jas21RICE/ENGI301/project_02/docs/Board_Screenshot.JPG

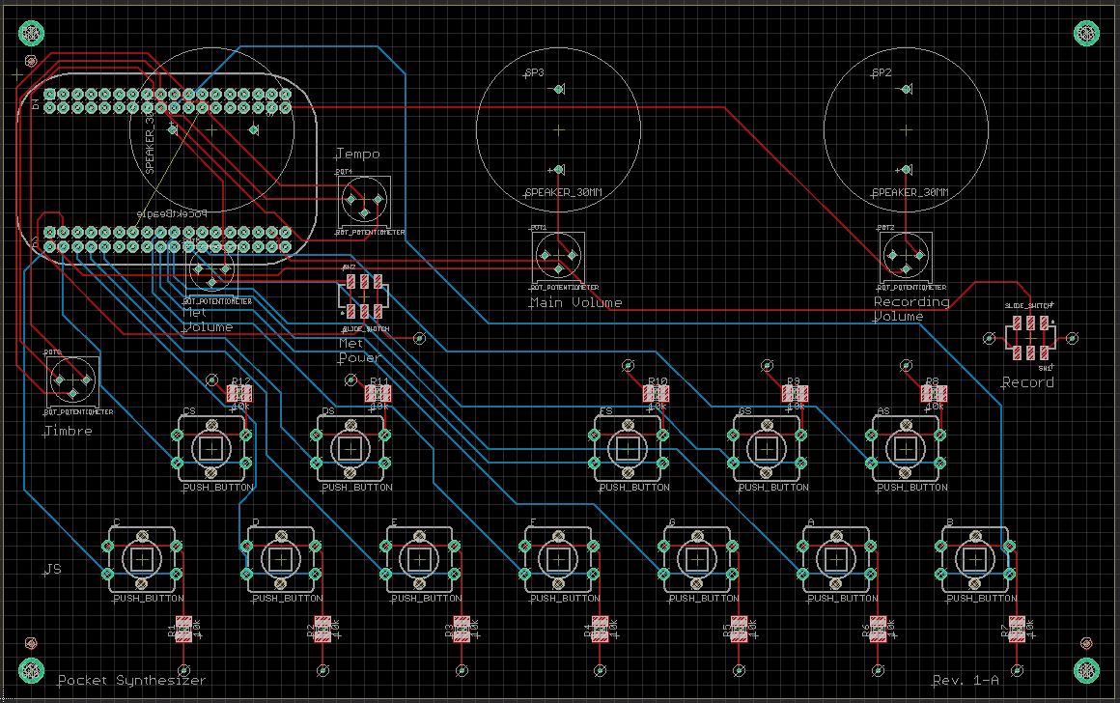
project_02/docs/Board_Screenshot.JPG
