jas21RICE/ENGI301/README.md

# ENGI301
Repository for ENGI 301 course work
