jas21RICE/ENGI301/project_02/README.md

# project_2
Repository for files regarding the Pocket Synthesizer PCB. 
These files are for manufacturing a PCB for a Pocket Synthesizer using the BeagleBoard PocketBeagle.
The project details can be found here: https://www.hackster.io/jas21/pocketbeagle-synthesizer-10f638
