jas21RICE/ENGI301/synthesizer_PCB/docs/ENGI301_project_2_proposal.pptx

## ENGI 301 Synthesizer PCB Proposal

10/20/2019
Josh Stelling

## Board Functionality

- This project will be a PCB that uses a PocketBeagle to make a miniature piano/synthesizer. The synthesizer has 12 keys, enough to cover a single octave of musical notes, and several other functions. There is a metronome that can be set to different speeds and different volumes, a potentiometer that allows the timbre of the notes to be adjusted. Lastly, there is an option that allows the user to play notes on the keys and the device will record the notes and play them back on a loop. The recording, metronome, and user inputs can all be played simultaneously, allowing the user to compose complex melodies and songs.

## Display/Controls Layout (Not to scale)

8”x5” board

Volume 1

Speaker 1

Met Speed

Volume 2

Speaker 2

Speaker 3

Pocket Beagle

Recording Switch

Timbre

Volume 3

Met PWR

Keys 0.8 inches apart

## System Block Diagram

Pocket Beagle

Speaker 1

Speaker 2

PWM1

PWM2

GPIO_IN

GPIO_IN

Timbre Pot

Tempo Pot

Speaker 3

PWM3

12 GPIO_IN

Record Switch

GPIO_IN
