jas21RICE/ENGI301/project_01/docs/ENGI301_project_proposal.pptx

## ENGI 301 Synthesizer Proposal

10/20/2019
Josh Stelling

## Background Information

- The device I’d like to make would be a small, relatively portable synthesizer that allows for rapid music composition and playback. The device would have the ability to play a range of notes with the option to switch between octaves. The device would also have a built in, adjustable metronome.
- Improvements
  - This device would have an integrated adjustable metronome as well as the ability to change the period over which a melody is repeated based on metronome beats. For example, a recording could be set to repeat after 6 beats of the metronome to allow for the ability to make a repeating 2-bar 3:4 melody.

## Background Information

- What is being proposed?
  - https://www.hackster.io/team-sunshine/keychain-synth-376159
    - Example of some synthesizer functionalities
  - https://www.hackster.io/95016/keyboard-melodies-9ac4ab
    - Example keyboard setup

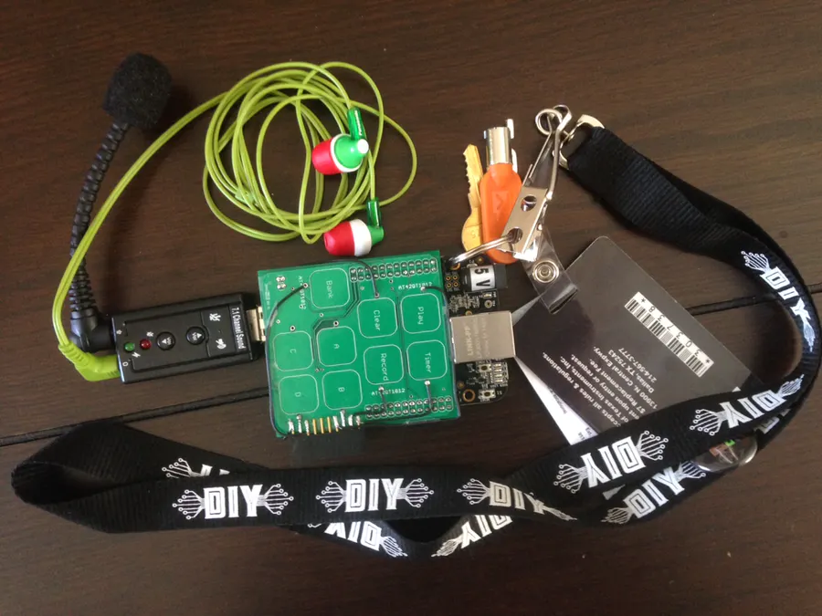
[picture p2: figure]
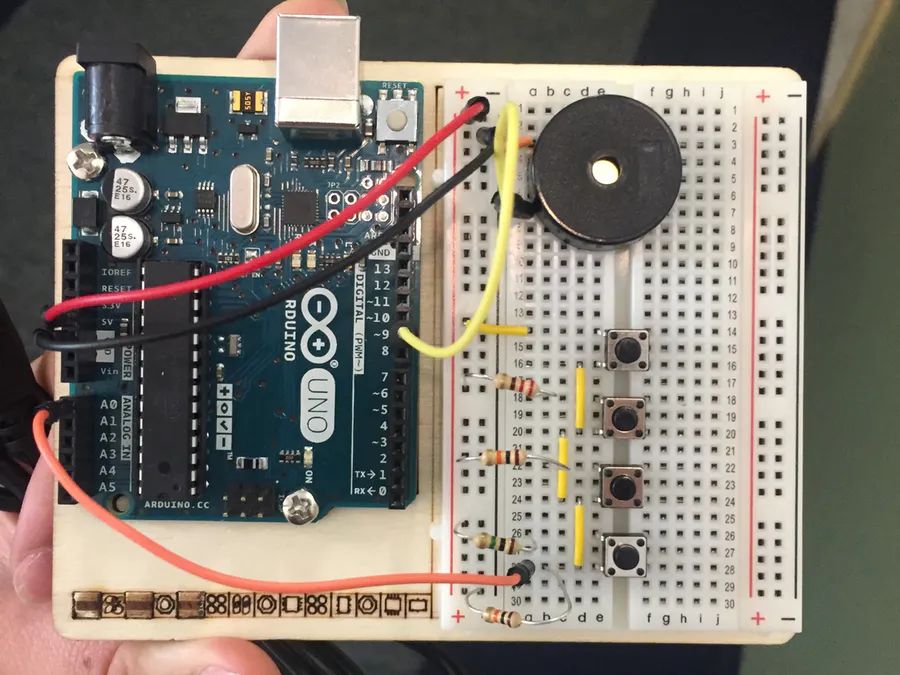
[picture p3: figure]

## Background Information

  - https://www.hackster.io/the-ohmonics/the-ohminator-analog-synthesizer-142dc7
    - Very complex full synthesizer
  - https://www.hackster.io/etiennedesportes/pocket-synthesizer-785b50
    - Another very complex synthesizer

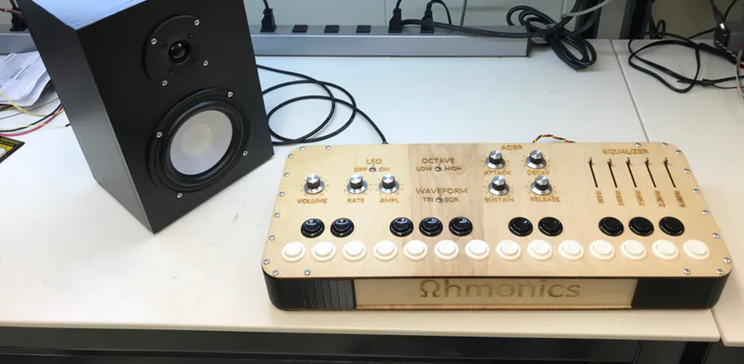
[picture p4: figure]
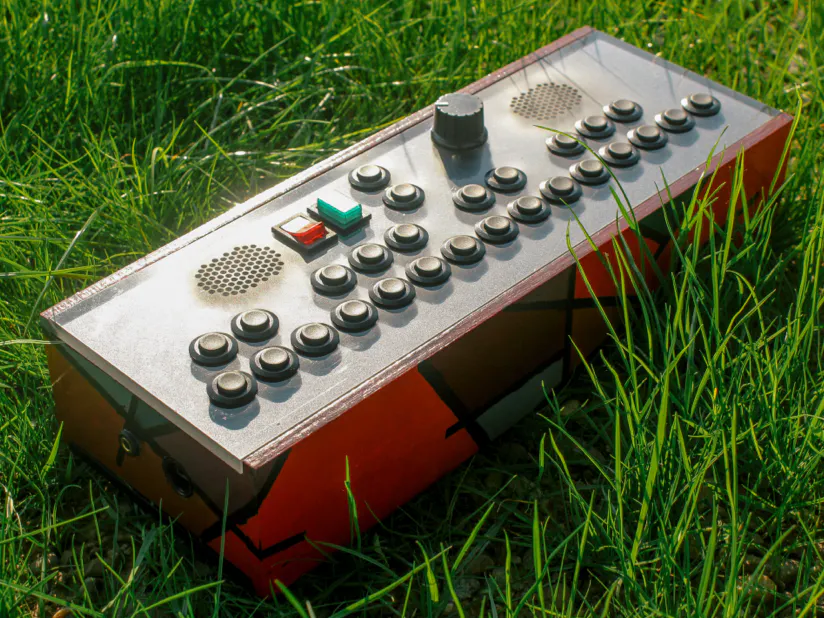
[picture p5: figure]

## Display/Controls Layout (Not to scale)

Speakers (May need multiple to allow for multiple tones, like metronome, active, and playback)

Metronome BPM, LED, BPM slider, and volume slider

Volume Slider

Recording beat interval and slider

120

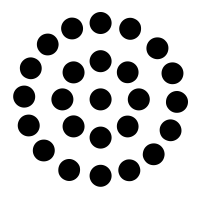
[picture p6: figure]

Beagle Power in

Clear Recording Button

8

Recording switch toggle

Keys

Octave Switch

## Old System Block Diagram

Pocket Beagle

Speaker 1

Speaker 2

PWM

PWM

GPIO_IN

Clear Button

Speaker 3

PWM

ANALOG_IN

2 Potentiometers

4 Digit Display

I2C1

PWM

LED

4 Digit Display

I2C2

12 Keys

12 GPIO_INs

Record Switch

GPIO_IN

Octave Switch

GPIO_IN

## Old Power Block Diagram

3.3 V, 140 mA

Pocket Beagle

3.3V, non-continuous

Speaker 1

Speaker 2

3.3 V, 140 mA

PWM

3.3V_OUT

Clear Button

Speaker 3

3.3 V, 140 mA

1.8V A ref

1.8V

2 Potentiometers

4 Digit Display

5 V, 2 200 mA

5 V, 200 mA

SYS_VOUT

PWM

3.3 V, Current Unsure

LED

4 Digit Display

12 Keys

3.3 V, Current Unsure

Record Switch

3.3 V, Current Unsure

3.3 V, Current Unsure

3.3V_OUT

Octave Switch

## New System Block Diagram

Pocket Beagle

Speaker 1

Speaker 2

PWM

PWM

Speaker 3

PWM

2 ANALOG_IN

2 Potentiometers

12 Keys

12 GPIO_INs

Record Switch

GPIO_IN

## New Power Block Diagram

3.3 V, 140 mA

Pocket Beagle

Speaker 1

Speaker 2

3.3 V, 140 mA

PWM

Speaker 3

3.3 V, 140 mA

1.8V A ref

1.8V

2 Potentiometers

12 Keys

3.3 V, Current Unsure

Record Switch

3.3 V, Current Unsure

3.3V_OUT

## Components / Budget

Component | Need to Buy | Cost
BeagleBoard | 0
Adafruit Mini-Speaker (1898) | 3 | 1.85
Adafruit I2C 7-segment Display (878) | 1 | 9.95
Adafruit Slide Potentiometer (4272) | 4 | 1.95
Resistors | 0
Switches | Probably 0
Buttons | Probably 0
LED | 0
Wood for Box | Maybe
