jas21RICE/ENGI301/project_02/docs/Board_Bot.JPG

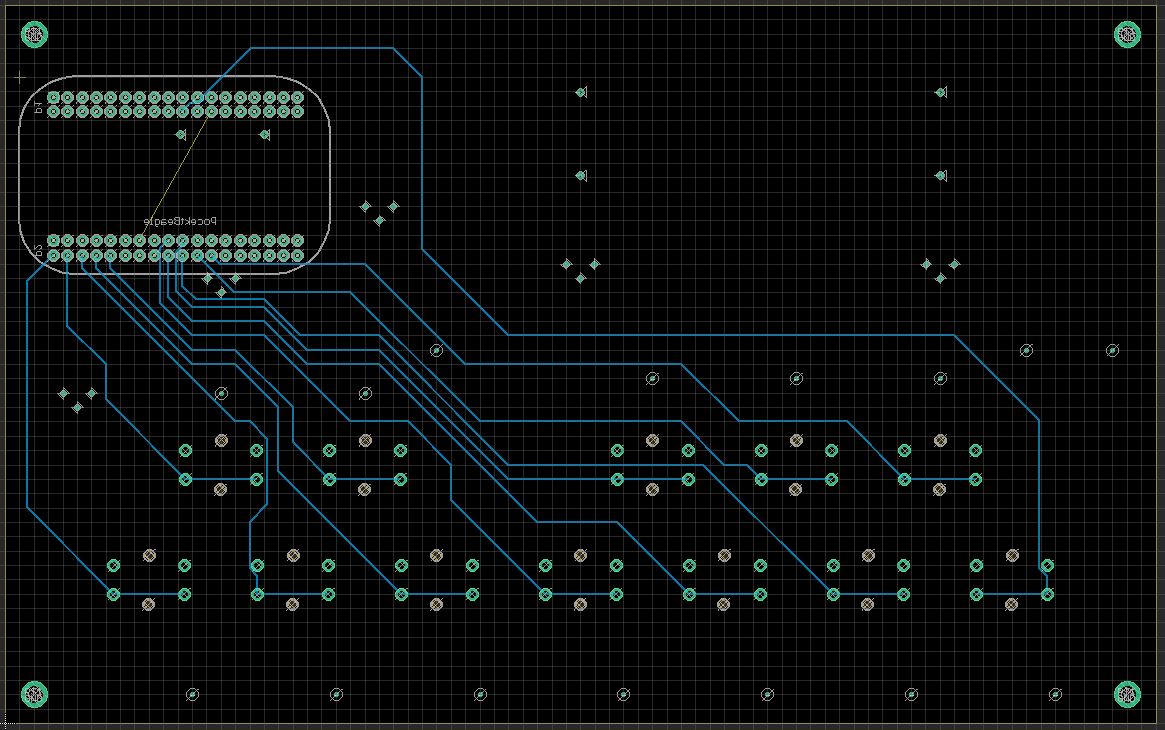
project_02/docs/Board_Bot.JPG
