jas21RICE/ENGI301/project_02/docs/Board_Top.JPG

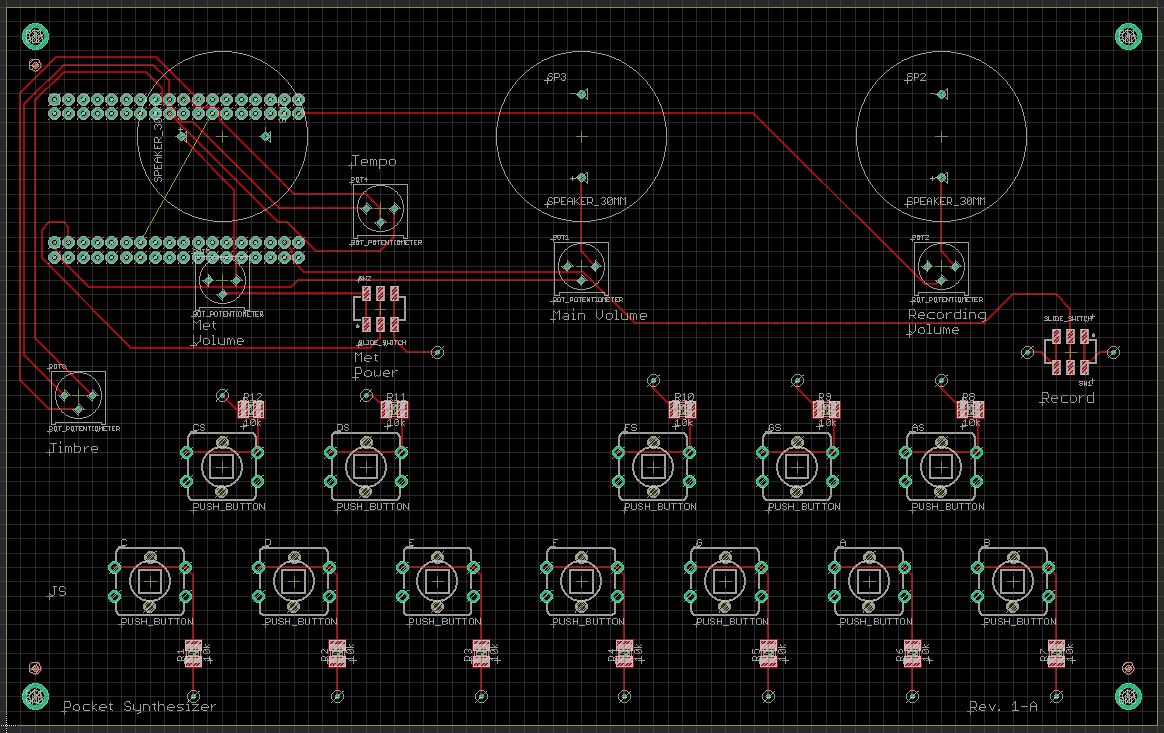
project_02/docs/Board_Top.JPG
