jas21RICE/ENGI301/project_02/Schematic.pdf

A

A

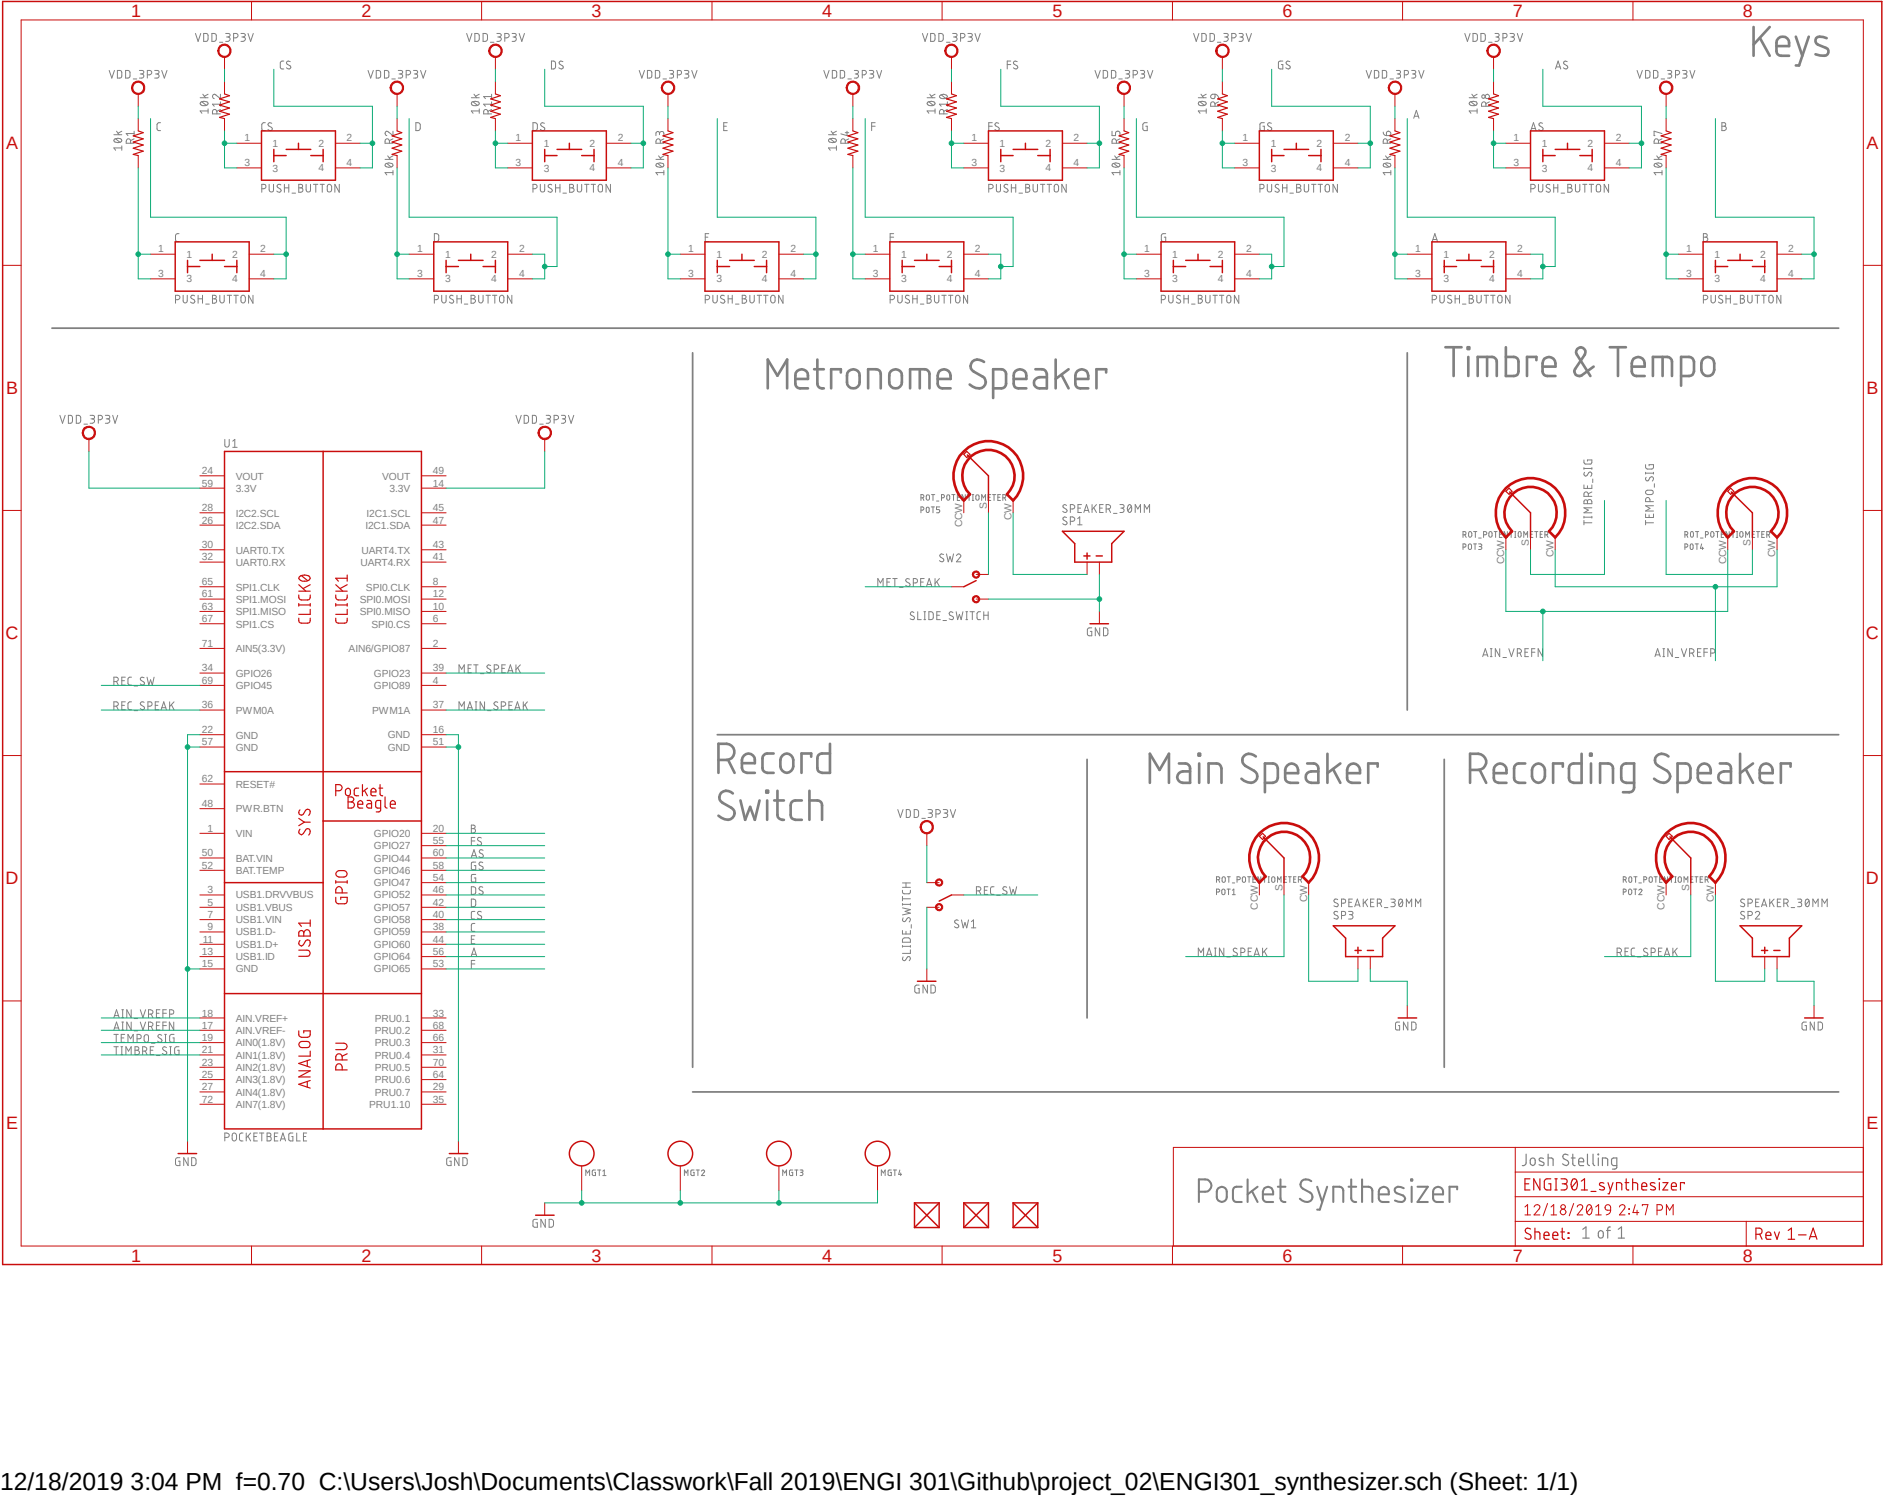
[picture p9: page 1]
VIN 1; USB1.DRVVBUS 3; USB1.VBUS 5; USB1.VIN 7; USB1.D- 9; USB1.D+ 11; USB1.ID 13; GND 15; AIN.VREF- 17; AIN0(1.8V) 19; AIN1(1.8V) 21; AIN2(1.8V) 23; AIN3(1.8V) 25; AIN4(1.8V) 27; PRU0.7; 29 PRU0.4; 31 PRU0.1; 33 PRU1.10; AIN6/GPIO87; 2 GPIO89; 4 SPI0.CS; 6 SPI0.CLK; 8 SPI0.MISO; 10 SPI0.MOSI; 14 GND; 16 AIN.VREF+ 18; GPIO20; 20 GND 22; VOUT 24; I2C2.SDA 26; I2C2.SCL 28; UART0.TX 30; UART0.RX 32; GPIO26 34; PWM0A 36; PWM1A; 37 GPIO23; 39 UART4.RX; 41 UART4.TX; I2C1.SCL; I2C1.SDA; 47 VOUT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

12/18/2019 3:04 PM f=0.70 C:\Users\Josh\Documents\Classwork\Fall 2019\ENGI 301\Github\project_02\ENGI301_synthesizer.sch (Sheet: 1/1)
