jas21RICE/ENGI301/(list of files, drawings)

Other design files:
project_01/Synthesizer_Fritzing_Diagram.fzz
