jas21RICE/ENGI301/project_02/ENGI301_synthesizer.brd

## EAGLE design project_02/ENGI301_synthesizer.brd (2019-12-18)

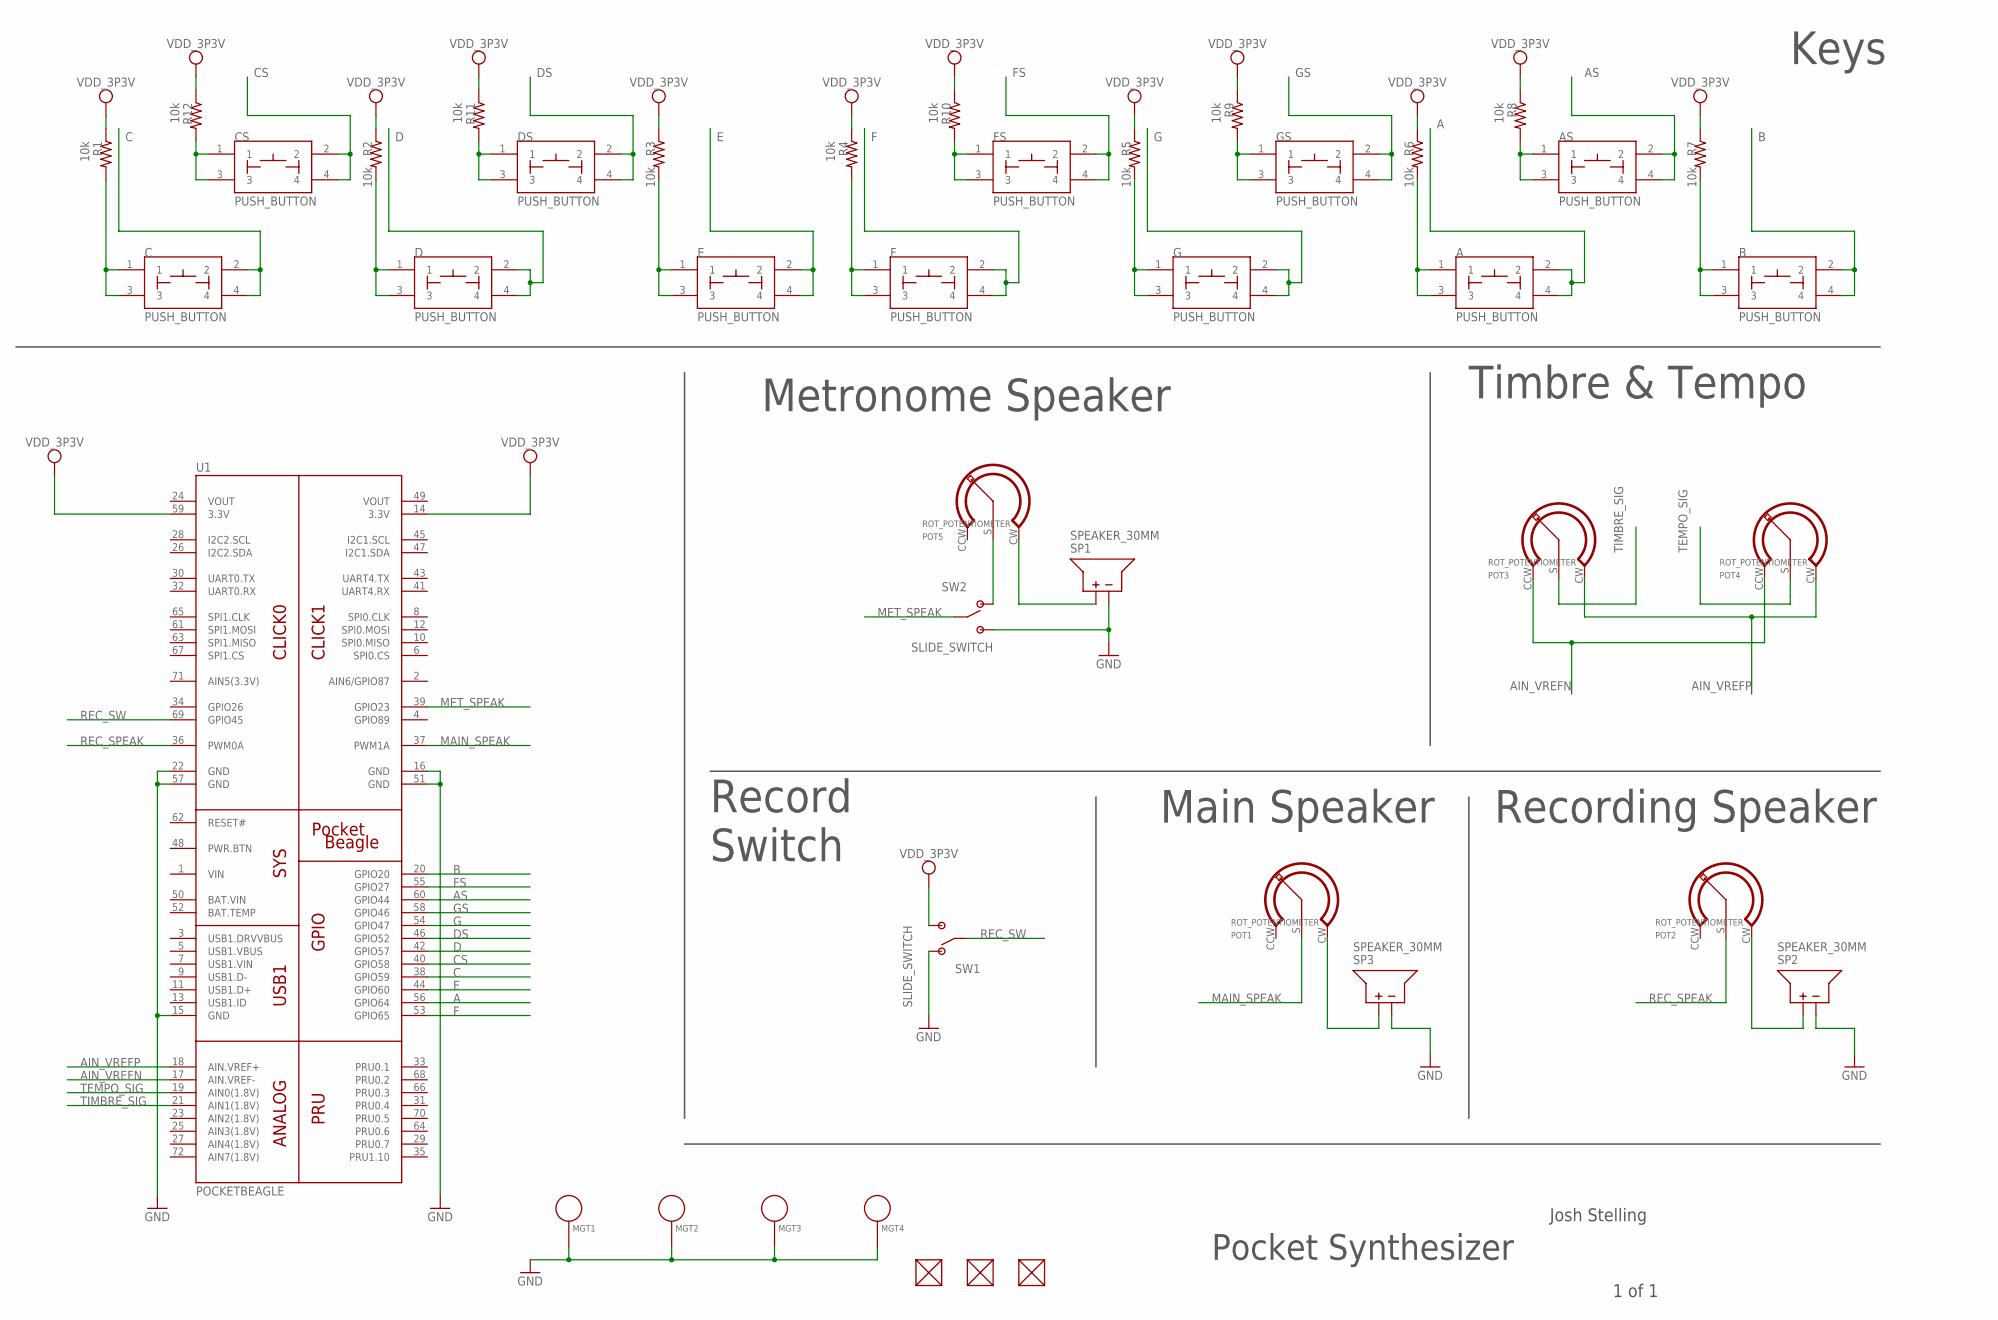
[picture p10: schematic ENGI301_synthesizer.sch]

Parts:
A: PUSH_BUTTON; BUTTON_12.5MM
AS: PUSH_BUTTON; BUTTON_12.5MM
B: PUSH_BUTTON; BUTTON_12.5MM
C: PUSH_BUTTON; BUTTON_12.5MM
CS: PUSH_BUTTON; BUTTON_12.5MM
D: PUSH_BUTTON; BUTTON_12.5MM
DS: PUSH_BUTTON; BUTTON_12.5MM
E: PUSH_BUTTON; BUTTON_12.5MM
F: PUSH_BUTTON; BUTTON_12.5MM
FS: PUSH_BUTTON; BUTTON_12.5MM
FUD1, FUD3, FUD4: FIDUCIAL; FIDUCIAL_40MIL
G: PUSH_BUTTON; BUTTON_12.5MM
GS: PUSH_BUTTON; BUTTON_12.5MM
MGT1, MGT2, MGT3, MGT4: MOUNTING_HOLE
POT1, POT2, POT3, POT4, POT5: ROT_POTENTIOMETER; POT-P102
R1, R2, R3, R4, R5, R6, R7, R8, R9, R10, R11, R12: 10k; R1210
SP1, SP2, SP3: SPEAKER_30MM
SW1, SW2: SLIDE_SWITCH; JS202011SCQN
U1: POCKETBEAGLE

Connections:
A: A.2, A.4, U1.56 (GPIO64)
AIN_VREFN: POT3.CCW, POT4.CCW, U1.17 (AIN.VREF-)
AIN_VREFP: POT3.CW, POT4.CW, U1.18 (AIN.VREF+)
AS: AS.2, AS.4, U1.60 (GPIO44)
B: B.2, B.4, U1.20 (GPIO20)
BAT.VIN: U1.50 (BAT.VIN)
C: C.2, C.4, U1.38 (GPIO59)
CS: CS.2, CS.4, U1.40 (GPIO58)
D: D.2, D.4, U1.42 (GPIO57)
DS: DS.2, DS.4, U1.46 (GPIO52)
E: E.2, E.4, U1.44 (GPIO60)
F: F.2, F.4, U1.53 (GPIO65)
FS: FS.2, FS.4, U1.55 (GPIO27)
G: G.2, G.4, U1.54 (GPIO47)
GND: MGT1.P$1, MGT2.P$1, MGT3.P$1, MGT4.P$1, SP1.-, SP2.-, SP3.-, SW1.1 (POS1), SW1.4 (POS1), SW2.3 (POS2), SW2.6 (POS2), U1.15 (GND), U1.16 (GND), U1.22 (GND), U1.51 (GND), U1.57 (GND)
GS: GS.2, GS.4, U1.58 (GPIO46)
MAIN_SPEAK: POT1.S (WIPER), U1.37 (PWM1A)
MET_SPEAK: SW2.2 (COMM), SW2.5 (COMM), U1.39 (GPIO23)
unnamed: C.1, C.3, R1.2
unnamed: D.1, D.3, R2.2
unnamed: POT5.CW, SP1.+
unnamed: POT5.S (WIPER), SW2.1 (POS1), SW2.4 (POS1)
unnamed: AS.1, AS.3, R8.2
unnamed: POT2.CW, SP2.+
unnamed: E.1, E.3, R3.2
unnamed: F.1, F.3, R4.2
unnamed: GS.1, GS.3, R9.2
unnamed: POT1.CW, SP3.+
unnamed: FS.1, FS.3, R10.2
unnamed: G.1, G.3, R5.2
unnamed: DS.1, DS.3, R11.2
unnamed: CS.1, CS.3, R12.2
unnamed: A.1, A.3, R6.2
unnamed: B.1, B.3, R7.2
REC_SPEAK: POT2.S (WIPER), U1.36 (PWM0A)
REC_SW: SW1.2 (COMM), SW1.5 (COMM), U1.69 (GPIO45)
TEMPO_SIG: POT4.S (WIPER), U1.19 (AIN0(1.8V))
TIMBRE_SIG: POT3.S (WIPER), U1.21 (AIN1(1.8V))
VDD_3P3V: R1.1, R2.1, R3.1, R4.1, R5.1, R6.1, R7.1, R8.1, R9.1, R10.1, R11.1, R12.1, SW1.3 (POS2), SW1.6 (POS2), U1.14 (3.3V), U1.59 (3.3V)
VIN: U1.1 (VIN)
VOUT: U1.24 (VOUT), U1.49 (VOUT)

Notes on the sheet:
Keys
Record Switch
Timbre & Tempo
Metronome Speaker
Main Speaker
Recording Speaker
Pocket Synthesizer
1 of 1
Josh Stelling

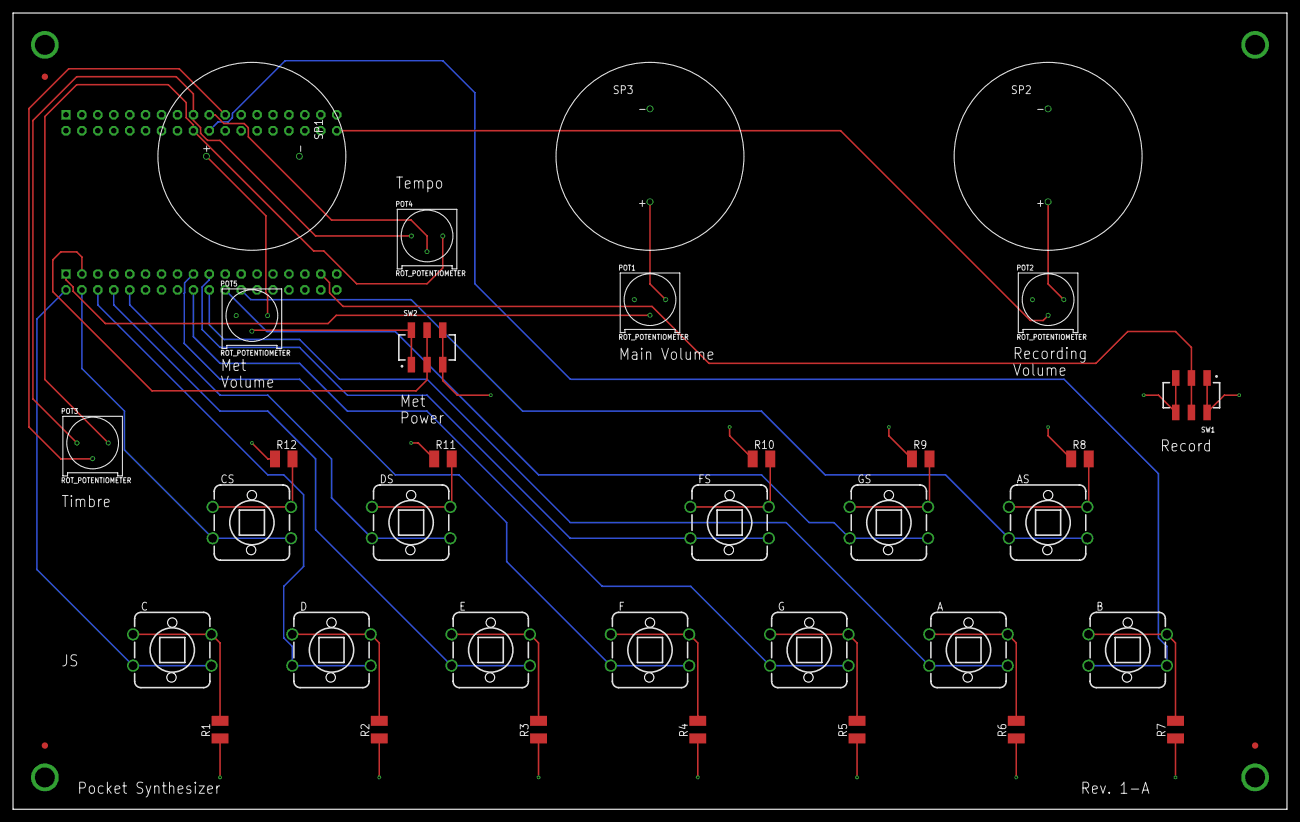
[picture p11: board ENGI301_synthesizer.brd from above]

Board: 4 copper layers, 203.2 x 127.0 mm, 42 parts (1 on the bottom side), 39 nets.
