jas21RICE/ENGI301/(commit log)

2019-10-07 Created program to blink USR3 LED on PocketBeagle
2019-11-19 Updated with final project files
    [Synthesizer_Fritzing_Diagram.fzz]
2019-11-27 PCB Project Proposal
2019-12-16 Uploading Schematic
    [ENGI301_synthesizer.brd, ENGI301_synthesizer.sch]
2019-12-17 Made Board
    [ENGI301_synthesizer.brd, ENGI301_synthesizer.sch]
